ibnteo/kladenets/README.md

[https://gitlab.com/ibnteo/kladenets](https://gitlab.com/ibnteo/kladenets)
