ibnteo/kladenets/firmware/promicro.c

/*
PD0 (3)     (A2) PF5  Rows
PD4 (4)     (A1) PF6    Cols
PC6 (5)     (A0) PF7    Cols
PD7 (6)     (15) PB1  Rows
PE6 (7)     (14) PB3    Cols
PB4 (8)     (16) PB2    Cols

PB5 (9)  Rows
*/

void Ports_Init() {

	// Init cols
	DDRB  |= 0b00011101; // B2,B3,B4, B0 (LED1)
	PORTB |= 0b00011101; // + LED Off
	DDRC  |= 0b01000000; // C6
	PORTC |= 0b01000000; // 
	DDRD  |= 0b00110000; // D4, D5 (LED2)
	PORTD |= 0b00110000; // + LED Off
	DDRE  |= 0b01000000; // E6
	PORTE |= 0b01000000; // 
	DDRF  |= 0b11000000; // F6,F7
	PORTF |= 0b11000000; // 

	// Init rows (PullUp)
	DDRB &= ~0b00100010; // B1,B5
	PORTB |= 0b00100010;
	DDRD &= ~0b10000001; // D0,D7
	PORTD |= 0b10000001;
	DDRF &= ~0b00100000; // F5
	PORTF |= 0b00100000;
}

void LED_On() {
	PORTD &= ~(1<<5);
}
void LED_Off() {
	PORTD |= 1<<5;
}
void LED_Toggle() {
	PIND ^= 1<<5;
}
void LED_Switch(bool on) {
	if (on) LED_On(); else LED_Off();
}


void Keyboard_Scan() {
	Chords[0] = 0;
	Chords[1] = 0;

	PORTB &= ~(1<<4); // B4
	_delay_us(1);
	if (! (PIND & 1<<0)) Chords[0] |= 1<<0; // D0
	if (! (PIND & 1<<7)) Chords[0] |= 1<<1; // D7
	if (! (PINB & 1<<5)) Chords[0] |= 1<<9; // B5
	PORTB |= 1<<4;

	PORTC &= ~(1<<6); // C6
	_delay_us(1);
	if (! (PIND & 1<<0)) Chords[0] |= 1<<2; // D0
	if (! (PIND & 1<<7)) Chords[0] |= 1<<3; // D7
	if (! (PINB & 1<<5)) Chords[0] |= 1<<8; // B5
	PORTC |= 1<<6;

	PORTE &= ~(1<<6); // E6
	_delay_us(1);
	if (! (PIND & 1<<0)) Chords[0] |= 1<<4; // D0
	if (! (PIND & 1<<7)) Chords[0] |= 1<<5; // D7
	PORTE |= 1<<6;

	PORTD &= ~(1<<4); // D4
	_delay_us(1);
	if (! (PIND & 1<<0)) Chords[0] |= 1<<6; // D0
	if (! (PIND & 1<<7)) Chords[0] |= 1<<7; // D7
	PORTD |= 1<<4;

	PORTB &= ~(1<<2); // B2
	_delay_us(1);
	if (! (PINF & 1<<5)) Chords[1] |= 1<<0; // F5
	if (! (PINB & 1<<1)) Chords[1] |= 1<<1; // B1
	if (! (PINB & 1<<5)) Chords[1] |= 1<<9; // B5
	PORTB |= 1<<2;

	PORTF &= ~(1<<7); // F7
	_delay_us(1);
	if (! (PINF & 1<<5)) Chords[1] |= 1<<2; // F5
	if (! (PINB & 1<<1)) Chords[1] |= 1<<3; // B1
	if (! (PINB & 1<<5)) Chords[1] |= 1<<8; // B5
	PORTF |= 1<<7;

	PORTF &= ~(1<<6); // F6
	_delay_us(1);
	if (! (PINF & 1<<5)) Chords[1] |= 1<<4; // F5
	if (! (PINB & 1<<1)) Chords[1] |= 1<<5; // B1
	PORTF |= 1<<6;

	PORTB &= ~(1<<3); // B3
	_delay_us(1);
	if (! (PINF & 1<<5)) Chords[1] |= 1<<6; // F5
	if (! (PINB & 1<<1)) Chords[1] |= 1<<7; // B1
	PORTB |= 1<<3;

	_delay_ms(5);
}
