ibnteo/kladenets/(commit log)

2019-06-25 letters heatmap
2019-06-28 mouse wheel
